sarahkemi/6s08-final-project/FinalReport.pdf

# Massachusetts Institute of Technology

# 6.S08 Final Project: MusicBuddy

Sarah Aladetan & Matias Hanco Date: May 12, 2016

### Documentation

MusicBuddy consists of two separate devices the device with LEDs to show chords and a remote to select the chords to show.

LED Hardware

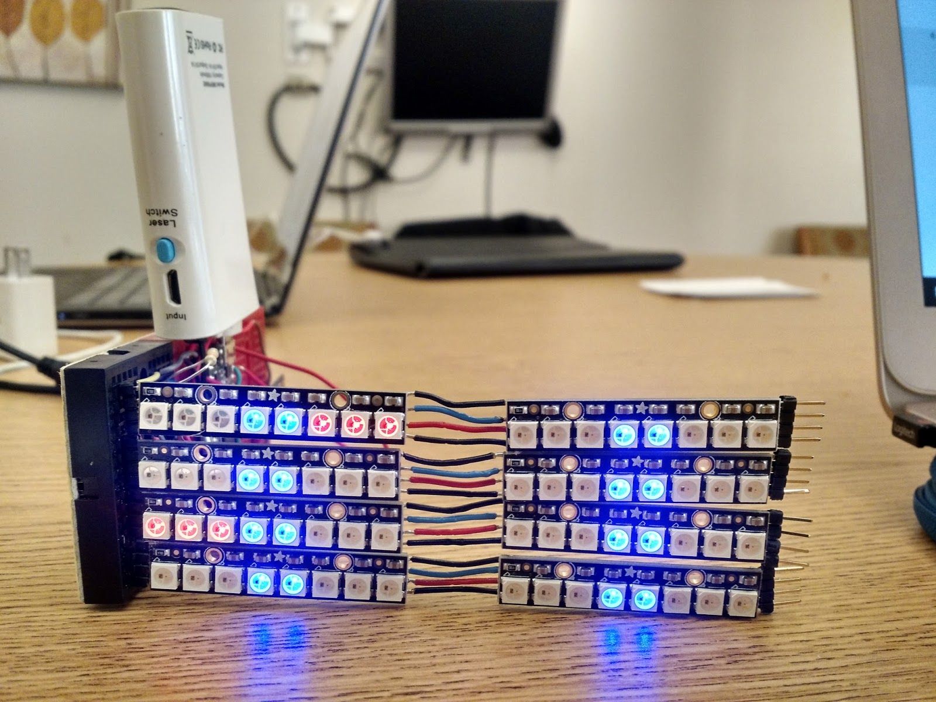
[picture p1: figure]

The main component of this hardware is the set of NeoPixel LED strips we have. [Insert image of strips] Since we wanted these strips to represent four frets of each string on the ukulele, we decided to have four sets (one for each string) of two strips (two strips could show ~4 frets on a single string) of NeoPixel LEDs that were wired together so that they would be easier to control.

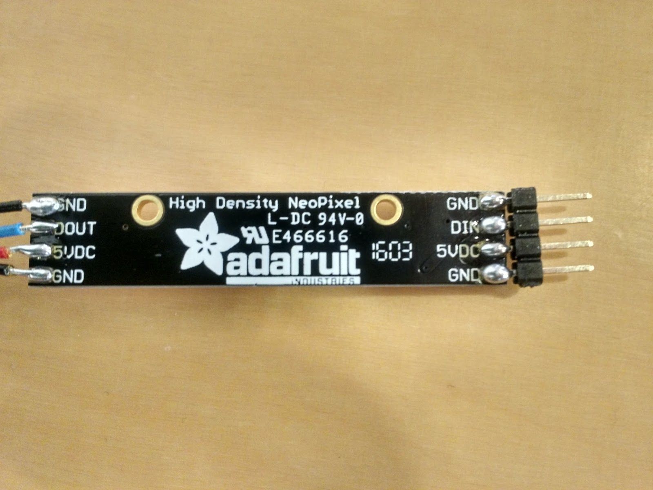
[picture p2: figure]

Each strip has four pads Ground, DIN, 5VCC, and another Ground. Since we want two strips to be connected, you need to solder on small wires on one side of a strip so that the DOUT pad matches with the DIN pad of another strip. This will allow us to communicate with both strips and tell them which of the LEDs to turn on. On the opposite sides of the two strips, we soldered on pins so that we could stick them into the breadboard (you could stick them either way it’s up to preference). Finally, stick in the black pin protectors.

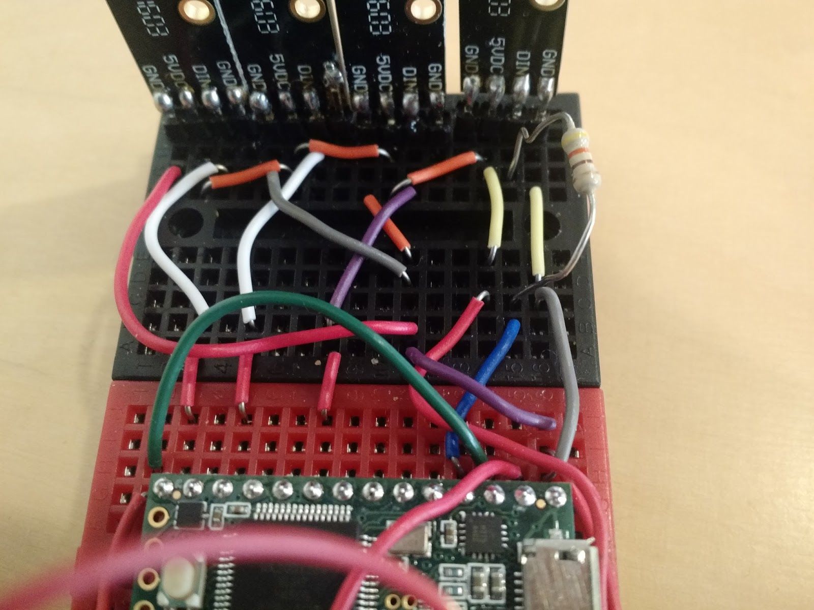
[picture p3: figure]

Now that we have the NeoPixel LEDs assembled, we have to connect them to the Teensy. As you can see in the image above, we have the rightmost strip connected to ground, while the rest of the other strips connect ground to a central hub, which from there has a wire connecting to ground. Of course, the layout for the wiring does not have to be exactly the same, it just needs to make sense (and if you can clean).

The power pins of each strip, however, are all connected via the orange wires (and one yellow wire). Again, we just decided to do this because it seemed more efficient. They all lead to this one red wire that snakes around the Teensy to the Vin pin, which is important. The NeoPixels require you to use the Vin pin instead of 3.3V since they could require a lot of power at higher brightness.

The DIN pads had a different wiring. Since each DIN was supposed to be independent from the others, we connected them to different Teensy digital pins, as shown by the small red bridge wires crossing the breadboards. The digital pins can be of your choosing just remember which digital pin controls which strip, and you’re good to go. As for the resistor at the first digital pin, we put it in the circuit because the NeoPixel tutorials told us it would ensure that the Teensy would not break the NeoPixel strip if the strip asked for too much power.

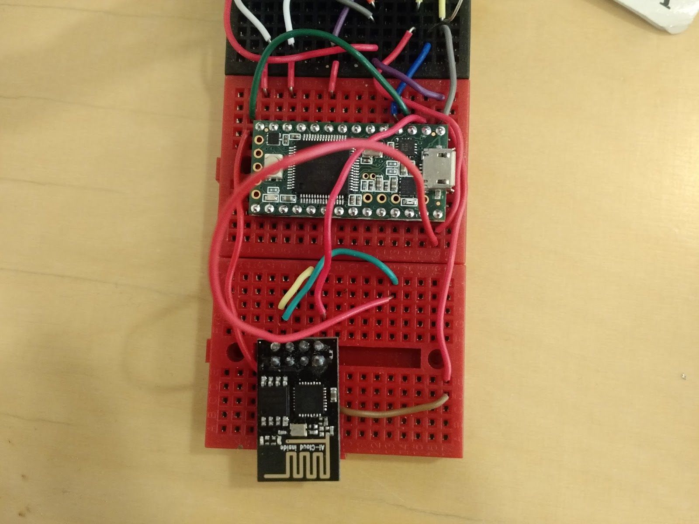
[picture p4: figure]

On the other side of the Teensy, we have another breadboard to house the Wifi chip. The setup is much like the tutorial given in one of the 6.S08 lessons, where the Teensy’s Ground connects to Ground, the RX of the Teensy connects to the TX of the WiFi, the TX of the Teensy connects to the RX of the WiFi, and the CH-PD also connects to VCC on the chip (as shown by the yellow wire).

Finally, the WiFi’s VCC connects to the Vin of the Teensy, a decision we made so that more power is given to send requests and display them on the NeoPixel strips in case there was a pattern to be displayed.

Once all this is set up, the LED hardware should be ready to be programmed.

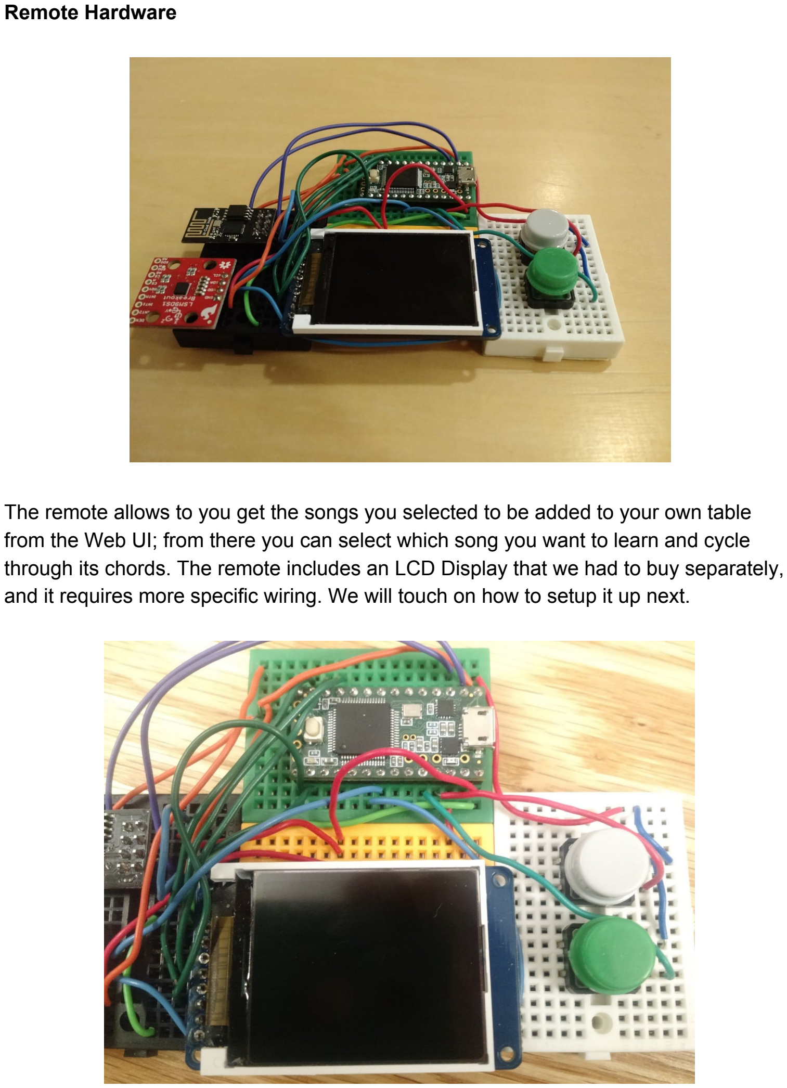
[picture p5: page 5]

Remote Hardware

The remote allows to you get the songs you selected to be added to your own table from the Web UI; from there you can select which song you want to learn and cycle through its chords. The remote includes an LCD Display that we had to buy separately, and it requires more specific wiring. We will touch on how to setup it up next.

Display

The picture above seems a bit obscure, but the green wires are the main ones that the display works with. The pin on the top right of the display is for Ground, so we used orange wires to connect it to a hub of other ground wires, with one last orange wire leading to the Teeny’s Ground pin. The pin second to the top right of the display is for power, so we connect it to the Vin pin of the Teensy using the light green wire.

The pin below that is the Reset pin, which we hooked up to pin 14 on our Teensy, but you can actually move it to any digital pin you want.

The pin below Reset is the D/C pin, which we set to RX2/ digital pin 9 on the Teensy. We were told by a guide to connect D/C to an RX pin, so that was why we decided to connect it to this specific pin.

Skip the next pin (CARD-CS) since we don’t use the card slot. The next pin is called TFT-CS, which we connected to TX2/ digital pin 10, again following the guide that said to connect to a TX pin.

The next pin is MOSI, which we connected to DOUT pin 11. The pin below MOSI is the SCK which we connected to digital pin 13, not because it controls the Teensy’s LED, but because it also doubles as the SCK pin

The last pin on the bottom right of the picture is the LITE pin which supports the display’s backlight. We have a light green wire connecting it to the VCC pin which will allow it to power up.

We are now done with wiring the LCD display!

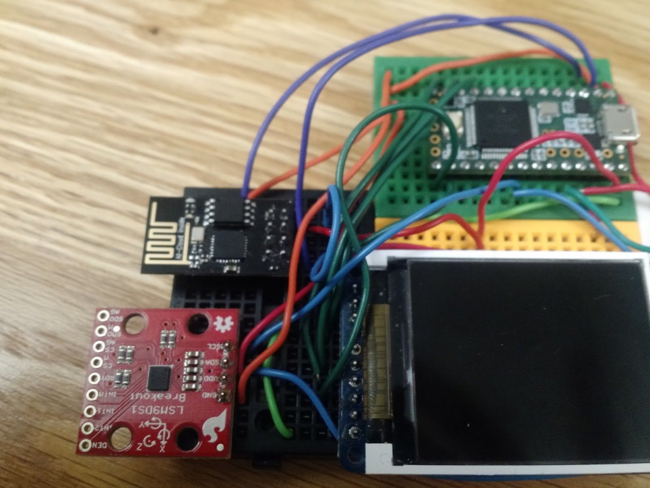
[picture p6: figure]

WiFi chip and IMU

The wiring for both components should be straightforward since they are exact same as the 6.S08 labs. There is only one difference we hooked up both to Vin as shown by the red wires leading out of them to provide more power, especially since the WiFi was having issues loading up at 3.3V.

Just like in the LED hardware, the WiFi’s RX and TX pins are wired to the TX and RX pins on the Teensy respectively and by the purple wires. The CH_PD pin is connected via the blue wire to VCC of the chip, and the Ground chip of the WiFi is connected via orange wire to the hub of other ground wires that all lead to the Teensy’s ground pin.

The ground pin for the IMU also has an orange wire that goes to that hub, and the SCL and SDA pins of the IMU are connected via blue wires to the SCL0 and SDA0 pins of the Teensy respectively. Finally, the VCC pin has a red wire connecting to Vin of the Teensy. After finishing that, the IMU and WiFi chip will be set up.

Buttons

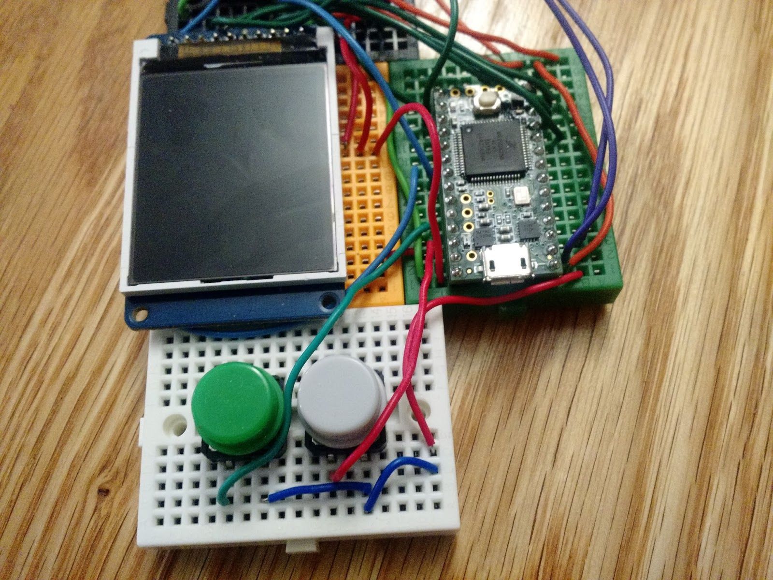
[picture p7: figure]

The final part of the remote consists of two buttons, a green one for selecting items on the display, and a gray one to move back from a selection. The wiring is pretty standard simply have one side of the buttons wired to a digital pin that you specify (remember which one to put into the code), and have the other side of each connected to ground, which we did using those blue and red wires that you see in the picture above.

The remote is set! Now all you have to do is code the devices, and they will work like the prototype we demonstrated on Thursday.

### Block Diagram

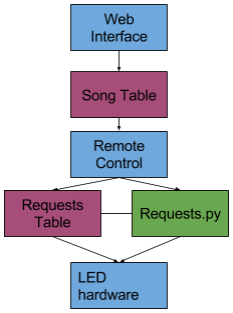
[picture p8: figure]

The following block diagram describes the Internet of Things loop our project follows. The loop starts with a web interfacethat allows the user to add/remove songs from their personal song database. From there, the remote controlcan make a request to requests.pyfor the songs from song table. When a user selects a song from the remote, a request in the form of a 4 digit pattern is sent to the requests table, using requests.py. From there, the LED hardwareis able to continuously check for a update to the requests database table. If there is a recent update, it will be pushed to the LED device.

### Design Challenges

The biggest design challenge we had to overcome was how the LEDs would be displayed and used. Originally, our idea was that the lights would be attached to the ukulele and shine on the individual frets, but we realized that wouldn’t work due to the way the strips were connected to each other and the precision of the LEDs. In the end, we decided that the LEDs would instead be a visualization device that the user would look at and then match their fingers on their ukulele to the corresponding lights on the device.

### Extra Parts

Description | Item No. | Vendor | Price
LCD Display | 358 | Adafruit | $19.95

LED Strip | 306 | Adafruit | $27.95

### Code Walkthrough

songtutor.io
The purpose of songtutor.io is to be the operating system and interface for the remote control hardware. It connects to wifi, receives the user’s songs and chords, allows the user to select a song, and sends requests to the server every time a user selects a chord in their chosen song. Also has power management features.

[code sets up declarations and includes libraries]

We start out our code file with three different classes: PowerMonitor, Selector, Angle. PowerMonitor and Angle are the same classes drawn from previous labs. Selector is a modification of the code created in the Wikipedia lab. Selector displays the list of all the titles, and allows the user to tilt their device using pitch (because the imu is aligned opposite our display). The user is then able to select a song using buttons on the device.

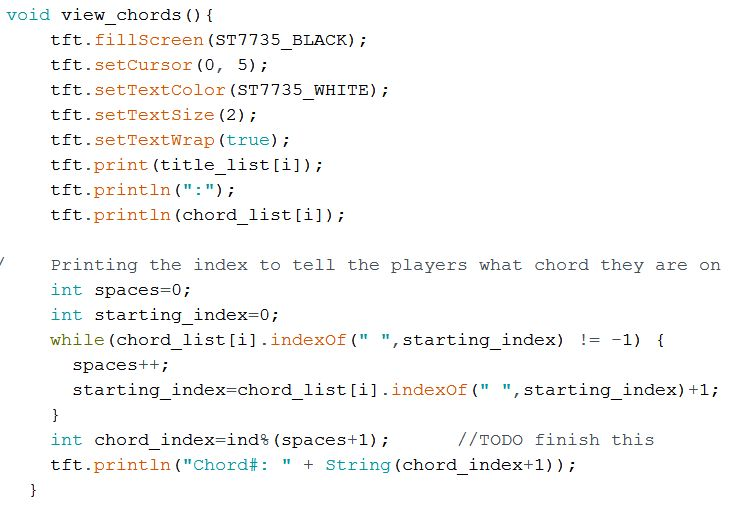
[picture p9: figure]

In the Selector class, we have also included a view_chords function that allows the prints the selected song and chords from the update function of the Selector class, and notifies the user which chord they are currently on.

In our setup loop, we change the typical IOT wifi setup a bit by only running the get request for the songs and chords once. After the system is setup, it uses the cached songs. We then parse through the html response to the get the titles and chords, and parse through our strings of chords and song titles to create two lists of each.

In our loop, we initialize the buttons and use them to change states. We also run if statements to turn on/off power saving functions based on the set interval. The loop updates the angle of the IMU, and if a movement boolean state is true, it updates the movement of the song selector. When the select button is pushed, it grabs the current song title, as well as the index of current chord selected. It then posts that information to our requests.py file and sets our movement boolean back to false.

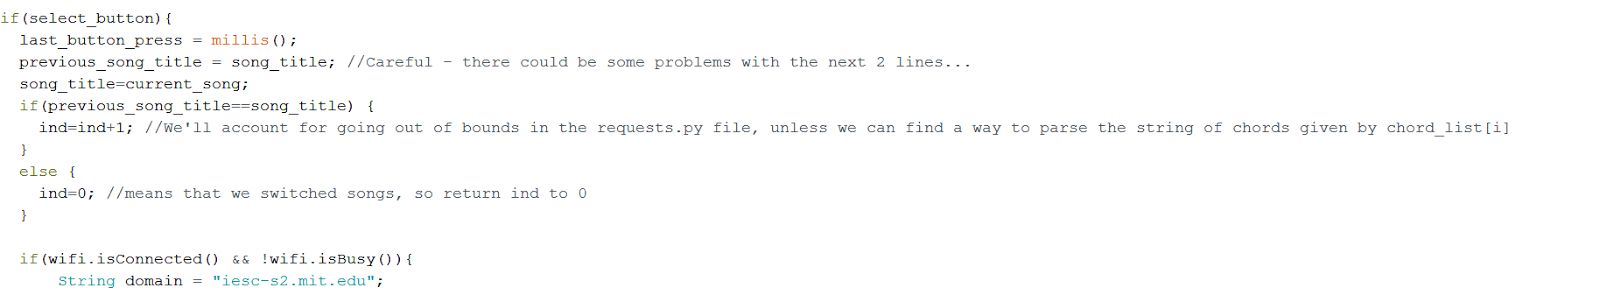
[picture p10: figure]

When the back button is selected, the screen is cleared, and movement is set back to true to allow for song selection to occur.

led.io
The purpose of led.ino is to act as a simple IoT loop that continuously checks for a new pattern request and maps that request to predefined “frets” on the strings.

[code sets up declarations and includes libraries]

In the constant declarations, 4 pins are assigned to be the four data pins on the NeoPixel LED strip, one strip for each string. Another important thing for code efficiency that occurs is that a list of all the string initializations is created to allow for easier looping through the strings later.

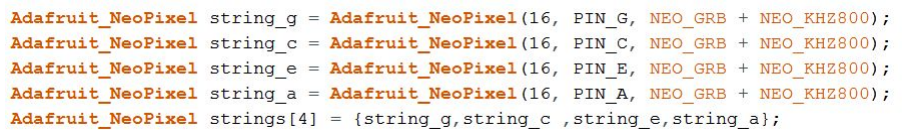
[picture p11: figure]

In the loop function, the wifi IoT magic occurs. The loop continuously makes a GET request to the server, where it receives either a 4-string chord pattern or stop code (‘5555’) . After the loop receives the pattern, the code parses the string of fret numbers and converts it into integers to feed to our chord function.

In our chord function, we make the LEDs shine (literally). The chord function takes in four parameters, which are integers correlating to the fret that needs to be lit for that string. We also have a frets matrix that defines the LEDs (in sets of three) that need to be lit up to show that fret.

After that, we have for statements that clear out the LEDs, set their brightness, and then light up defined “fret dividers” for easier visualization of the chords. Following that, we have one last for loop that iterates through the pattern fed to the chord function and using our frets matrix, lights up the specified frets.

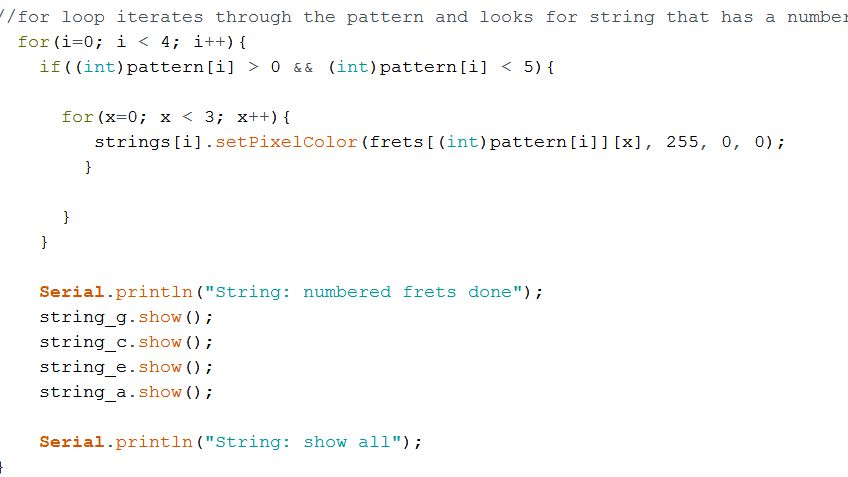
[picture p12: figure]

web.py
The purpose of web.py is to act as an allinone web client. It is the frontfacing web interface for users to view their songs in their personal database, as well as take in the post requests needed to add/remove songs from the database.

The code is basically split up into two sections, the GET and the POST request. For the GET request, the code acts similarly to the messaging client lab in that it expects a valid username/password from the users dictionary. If it receives a valid combo, it will print the body variable (which holds all the html/css/javascript) for the page, feeding in songs from a request to the database class.

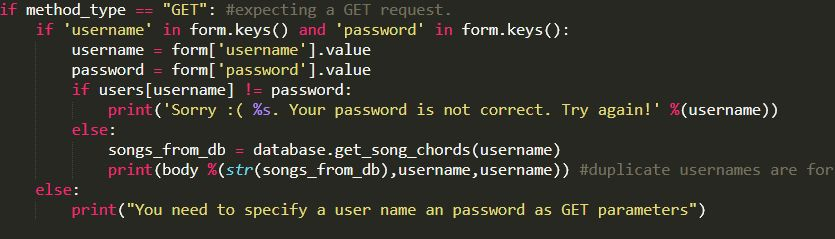
[picture p13: figure]

For the POST request, it branches down two paths based on what action parameter is received.If the action is ‘add’, the post request adds the specified title and chords to the database. If it’s ‘remove’, it removes that specific title from the user’s database.

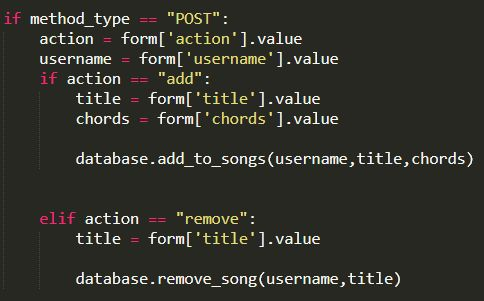
[picture p14: figure]

requests.py
Request.py is a script that interacts with both the remote and LED hardware to get and post songs and chord patterns.

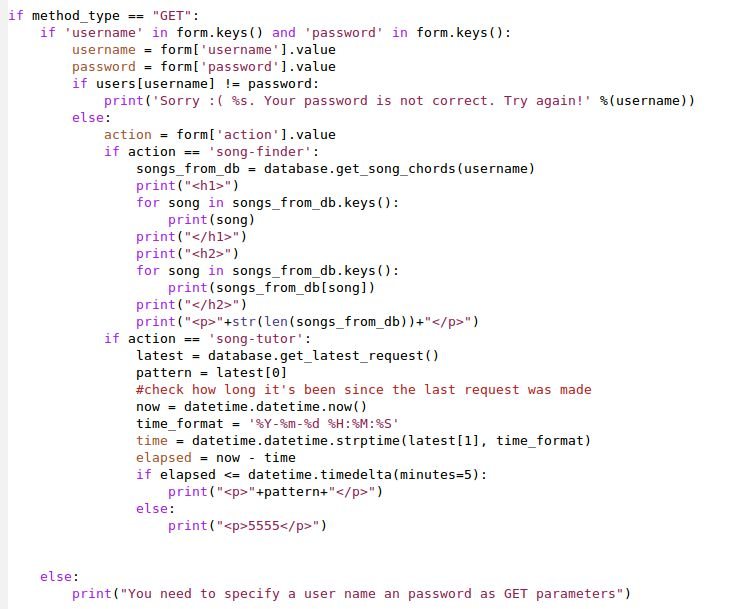
[picture p15: figure]

The first event the file looks for is if there is a GET request from one of the devices. It there is, then it will check to see if the username and password match to an entry in the master list, and if so it finds which device is asking for a get request. If it is the remote, the action will be ‘songfinder’, and the file will pull up the database for the specific songs that user has added to their songs table. The result will be returned and shown on the remote’s display.

If the action is ‘songtutor’, it means that the LED hardware is listening for a chord. If there has been a chord posted on the requests table of the database within the past 5 minutes, requests.py will pull up the most recent posted chord pattern and return ir for the NeoPixel LED strips to show. If there is no pattern, it return the pattern that turns off the lights.

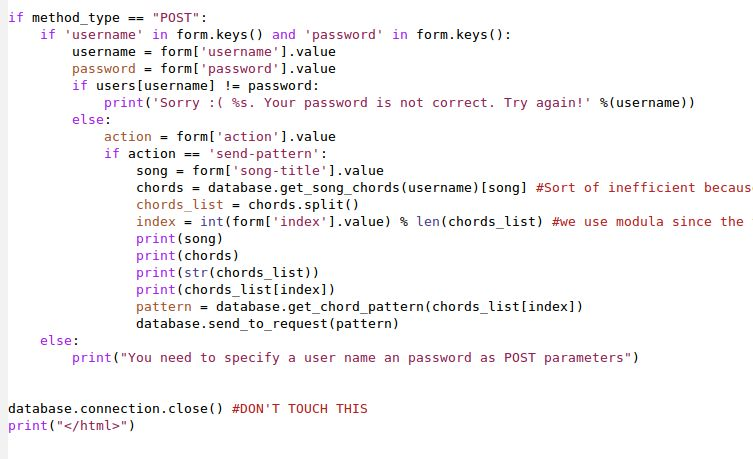
[picture p16: figure]

If the remote is doing a POST request, the file will first check to see if the username and passwords match, and if so it will get the current song selected and the index from the POST request. This is sort of inefficient since the file looks for the same song even though it could have been selected before the buttons is pressed, but it seemed to work well enough for us to keep. After looking through tables, it will retrieve the pattern to post to the requests table of the database.

database.py
This file has all to do with the tables of our database and the database itself. It has functions that add entries to the tables and functions that retrieve data from the tables. We used the _mysql library and the connection methods (especially connection’s query method) to make change to the db file that stored all of our tables.

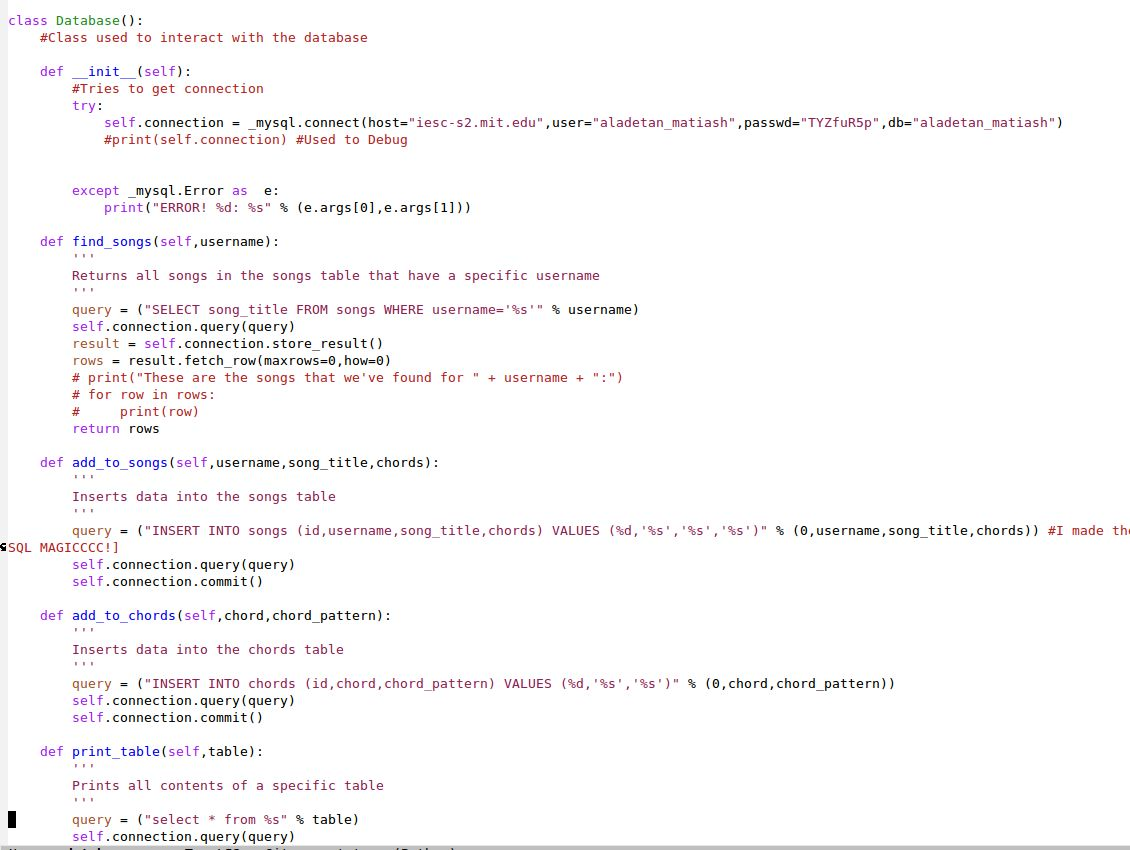
[picture p17: figure]

There are many methods in the Database class we created, and many of them are self explanatory. For example, find_songs returns all of the songs that a username has on their table. add_to_songs() adds an entry to to the songs table. add_to_chords() and print_table() are also self explanatory, so we’ll move through to the next section.

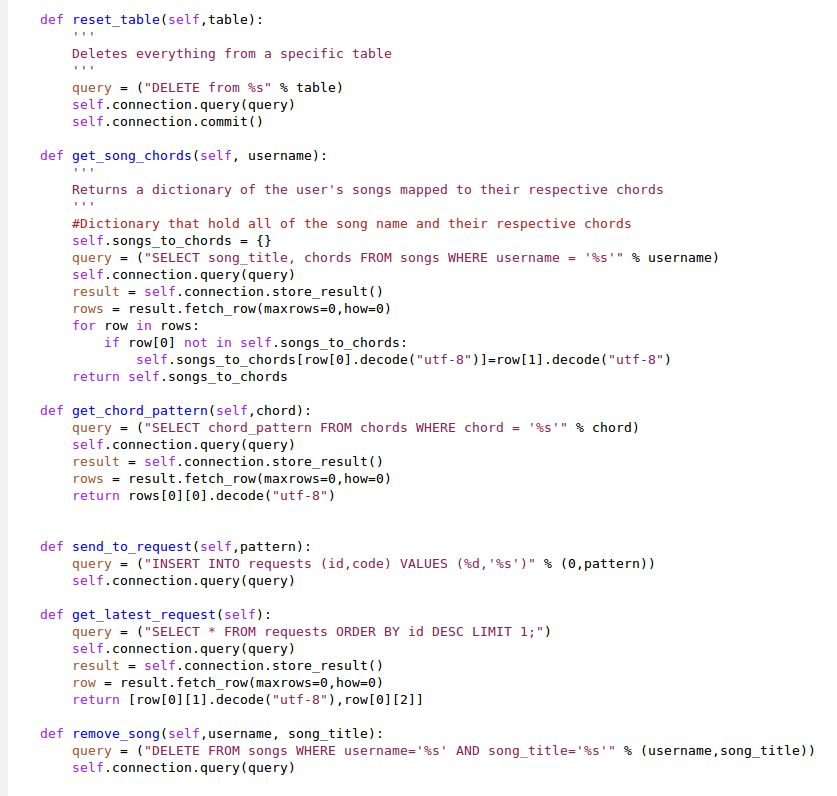
[picture p18: figure]

The second section of database.py holds more important functions.
- get_song_chords() is documented above, return a dictionary of a user’s songs and each of the songs’ chords
- get_chord_pattern() looks through the chords table to extract the correct pattern
- send_to_request() posts a chord pattern to the requests table
- get_latest_request() is what we used to find the last pattern that we should show to the LED hardware
- remove_song() removes a song from the user’s song table if he or she does not want it anymore, which can be done through the web UI.

### Power Management

For power management capabilities in our IoT project, we decided to use the PowerMonitor class from the power labs. From there we decided to set an interval for which the device would have to sit still with no button presses. When that interval has been surpassed, we shut down the teensy & wifi chip, and then clear the screen with a black rectangle. When a button is pushed, the system wakes up, and the teensy and wifi chip are turned back on, and the song menu is displayed on the screen.
For the led hardware, the LEDs turn off after five minutes if there has been no new request sent to the requests database.

### Final Thoughts

We would like to thank all of the staff and lecturers for the suggestions and help they gave us during the project this would not have been done without your support!
