sarahkemi/6s08-final-project/Final presentation.pdf

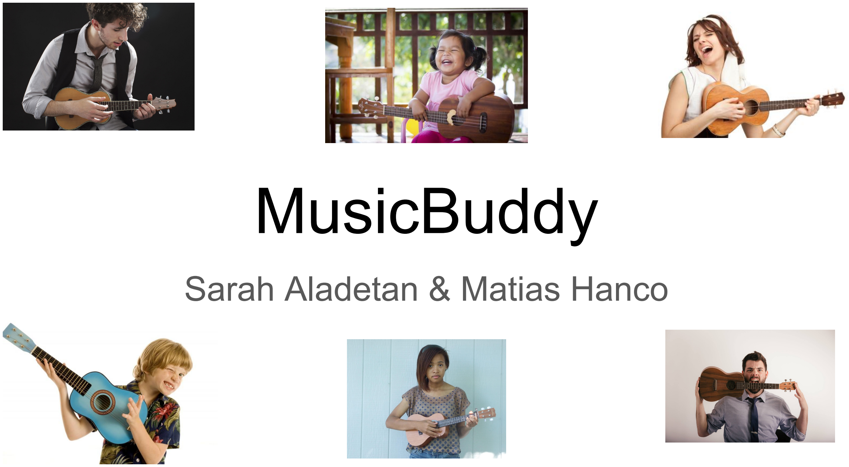
[picture p19: page 1]

# MusicBuddy

## Sarah Aladetan & Matias Hanco

## Why MusicBuddy?

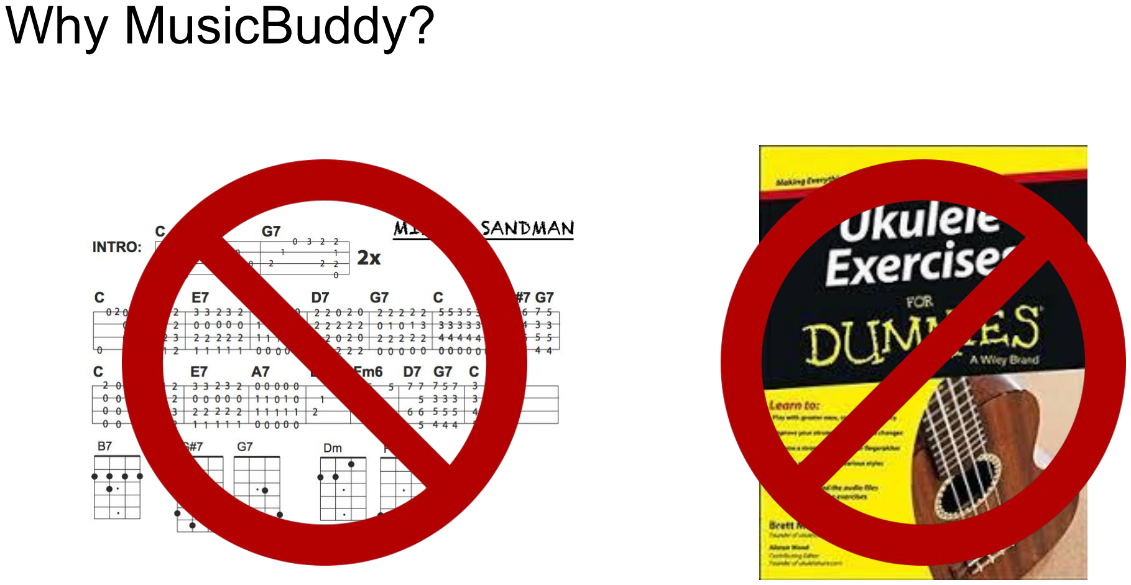
[picture p20: page 2]

## Features

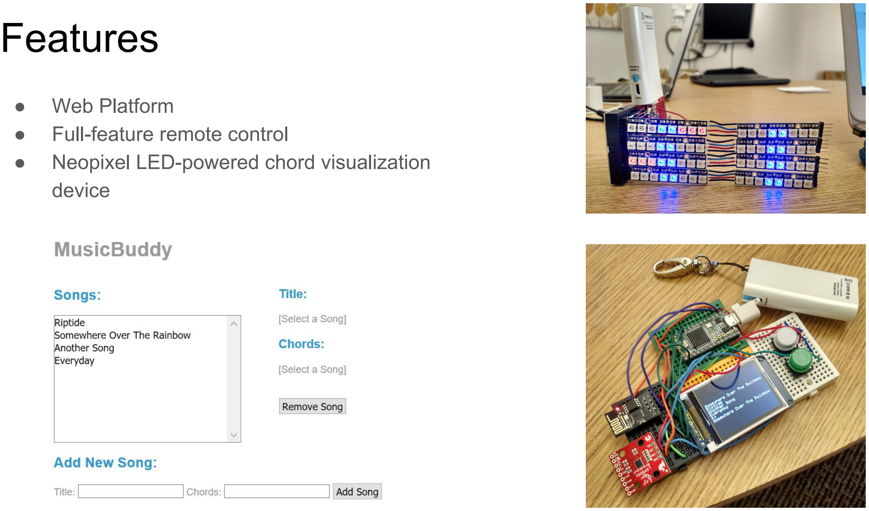
[picture p21: page 3]

- Web Platform
- Full-feature remote control
- Neopixel LED-powered chord visualization device

# Live Demo

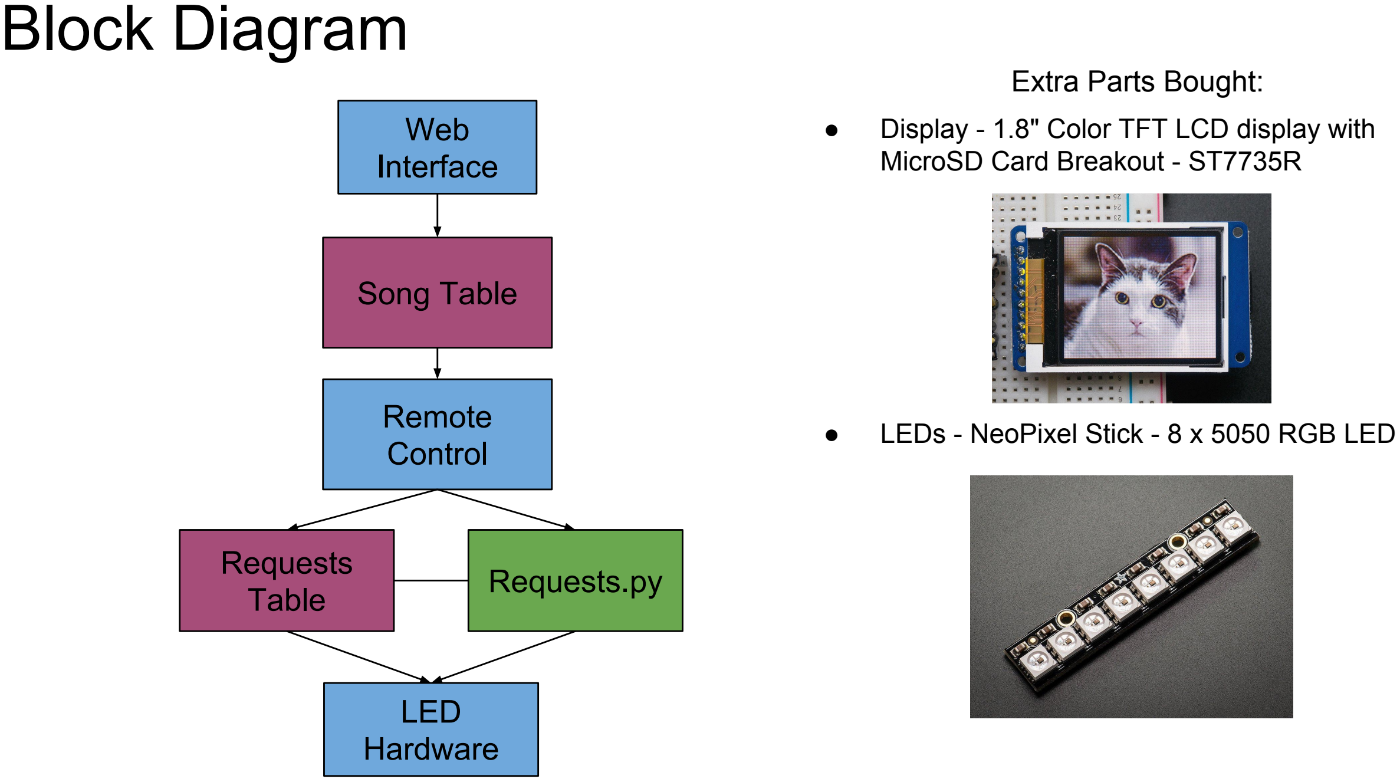
[picture p22: figure]
Block Diagram; Extra Parts Bought:; MicroSD Card Breakout - ST7735R; Web Interface; Song Table; Remote Control; LED Hardware; Requests; Table; Requests.py

- Display - 1.8" Color TFT LCD display with
- LEDs - NeoPixel Stick - 8 x 5050 RGB LED

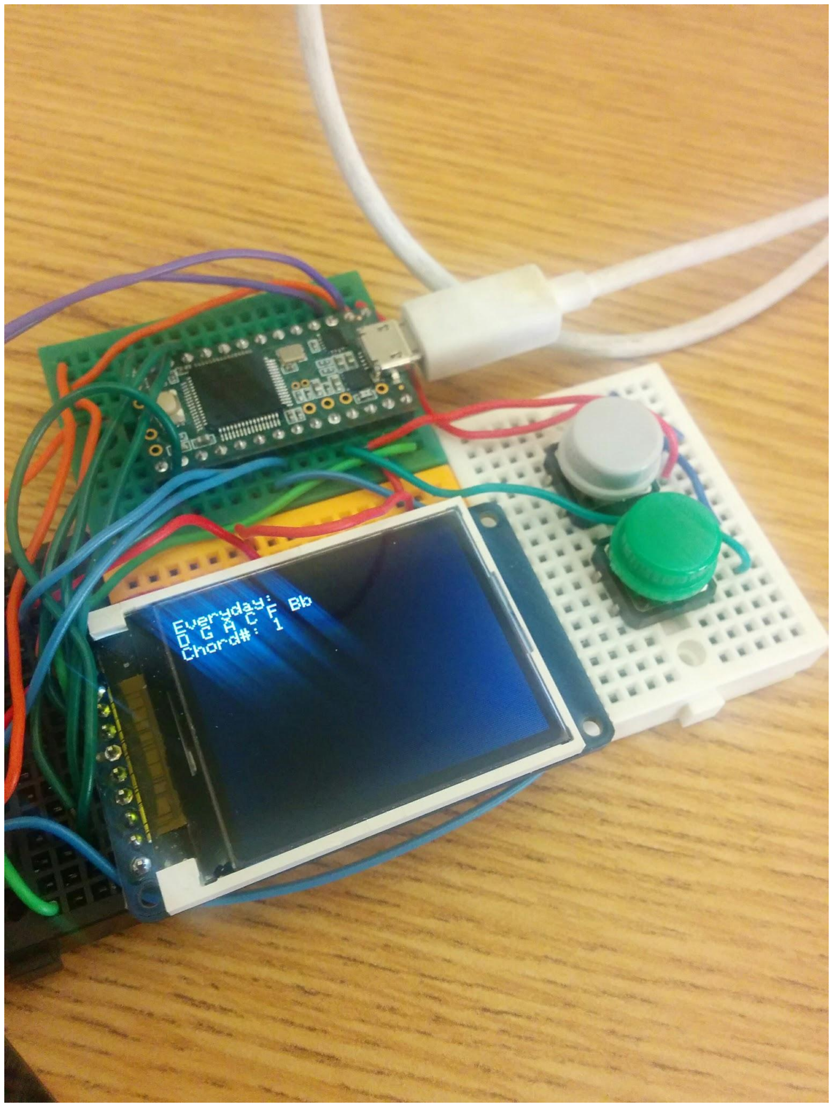
[picture p23: figure]

## Challenges

- NeoPixel Strips being unresponsive
- Installing new display
- Incorporating power management features
- Splitting strings in Arduino C/C++

## What We Learned

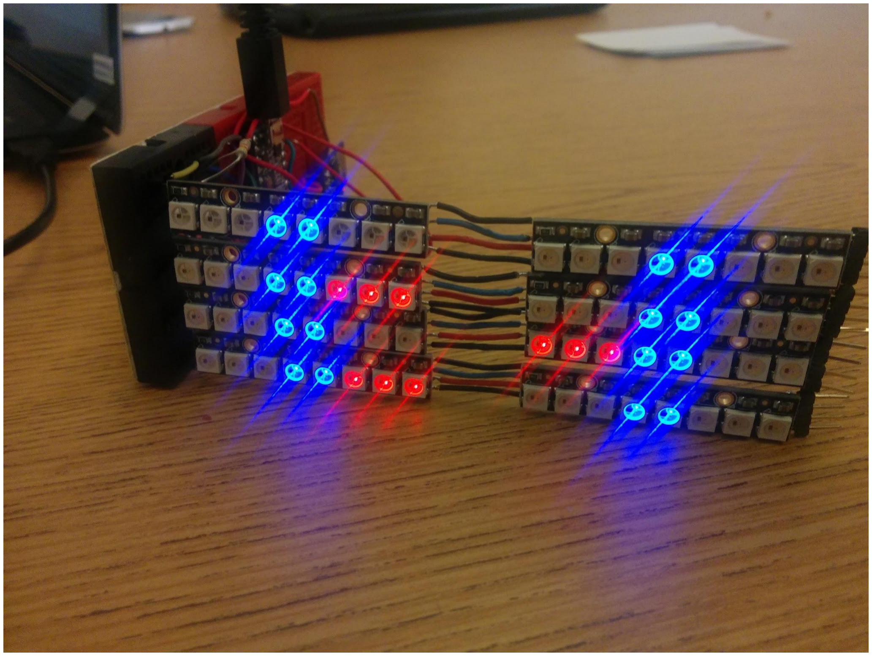
[picture p24: figure]

- Figuring out how to work with new hardware
- Team collaboration
- Shared repository
- Being open to advice
- Web development/SQL skills

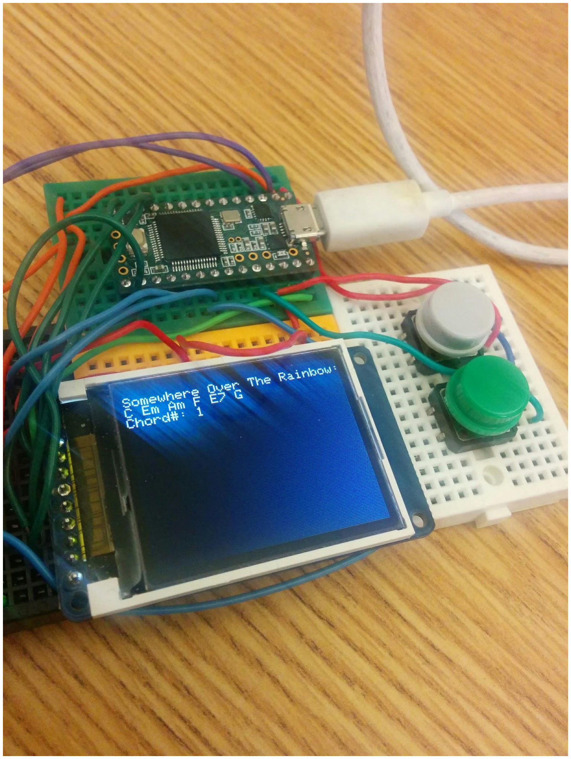
[picture p25: figure]

## Next Steps

- GPS locator - Jamming with Friends
- Tuner
- Phone app to replace remote control
- Solder both LED and remote component
- Package components in 3D printed encasing

# Questions?
