sarahkemi/6s08-final-project/(commit log)

2016-04-21 Created demo for displaying chords on LED hardware
2016-04-26 Edited database.py to output different things for find_songs. Created requests.py to handle teensy requests
2016-04-30 Updated database.py to include a method for retrieving chord patterns from a specific chord, and updated the pin number of chordstest.ino to match the new pin for the G string.
2016-05-01 Added method in database.py to insert a chord pattern in the request table
2016-05-03 Fixed missing code from current requests.py (in song-tutor branch). Merge from last weekend made things very confusing
2016-05-03 Somewhat working code for led teensy. Weird serial errors though
    [led.ino]
2016-05-04 Trying so hard to debug serial (possibly neopixel related problem)
    [led.ino]
2016-05-04 Added functionality for sending patterns to the request table in the database whenever the green button is clicked on a song. The chord patterns will cycle through upon multiple button clicks.
2016-05-05 Added a feature to the remote that shows the player which chord he or she is currently on.
2016-05-05 Swtiched showing chords from 0-indexed to 1-indexed; switched title Index to Chord#.
2016-05-05 Added power saving mode
2016-05-05 Changed delays in power saving mode
2016-05-09 Song-tutor works on my computer, inputBuffer full error on yours
    [led.ino, song-tutor.ino]
2016-05-10 Cleaned up Arduino code and erased debugging comments
2016-05-20 Final commit?? Added chord_pusher pebble app, small changes to led & song-tutor
